mgottschlag/nrf24l01-stick/hardware/nrf24l01-stick.kicad_pcb

## KiCad design hardware/nrf24l01-stick.kicad_pcb (2021-01-23)

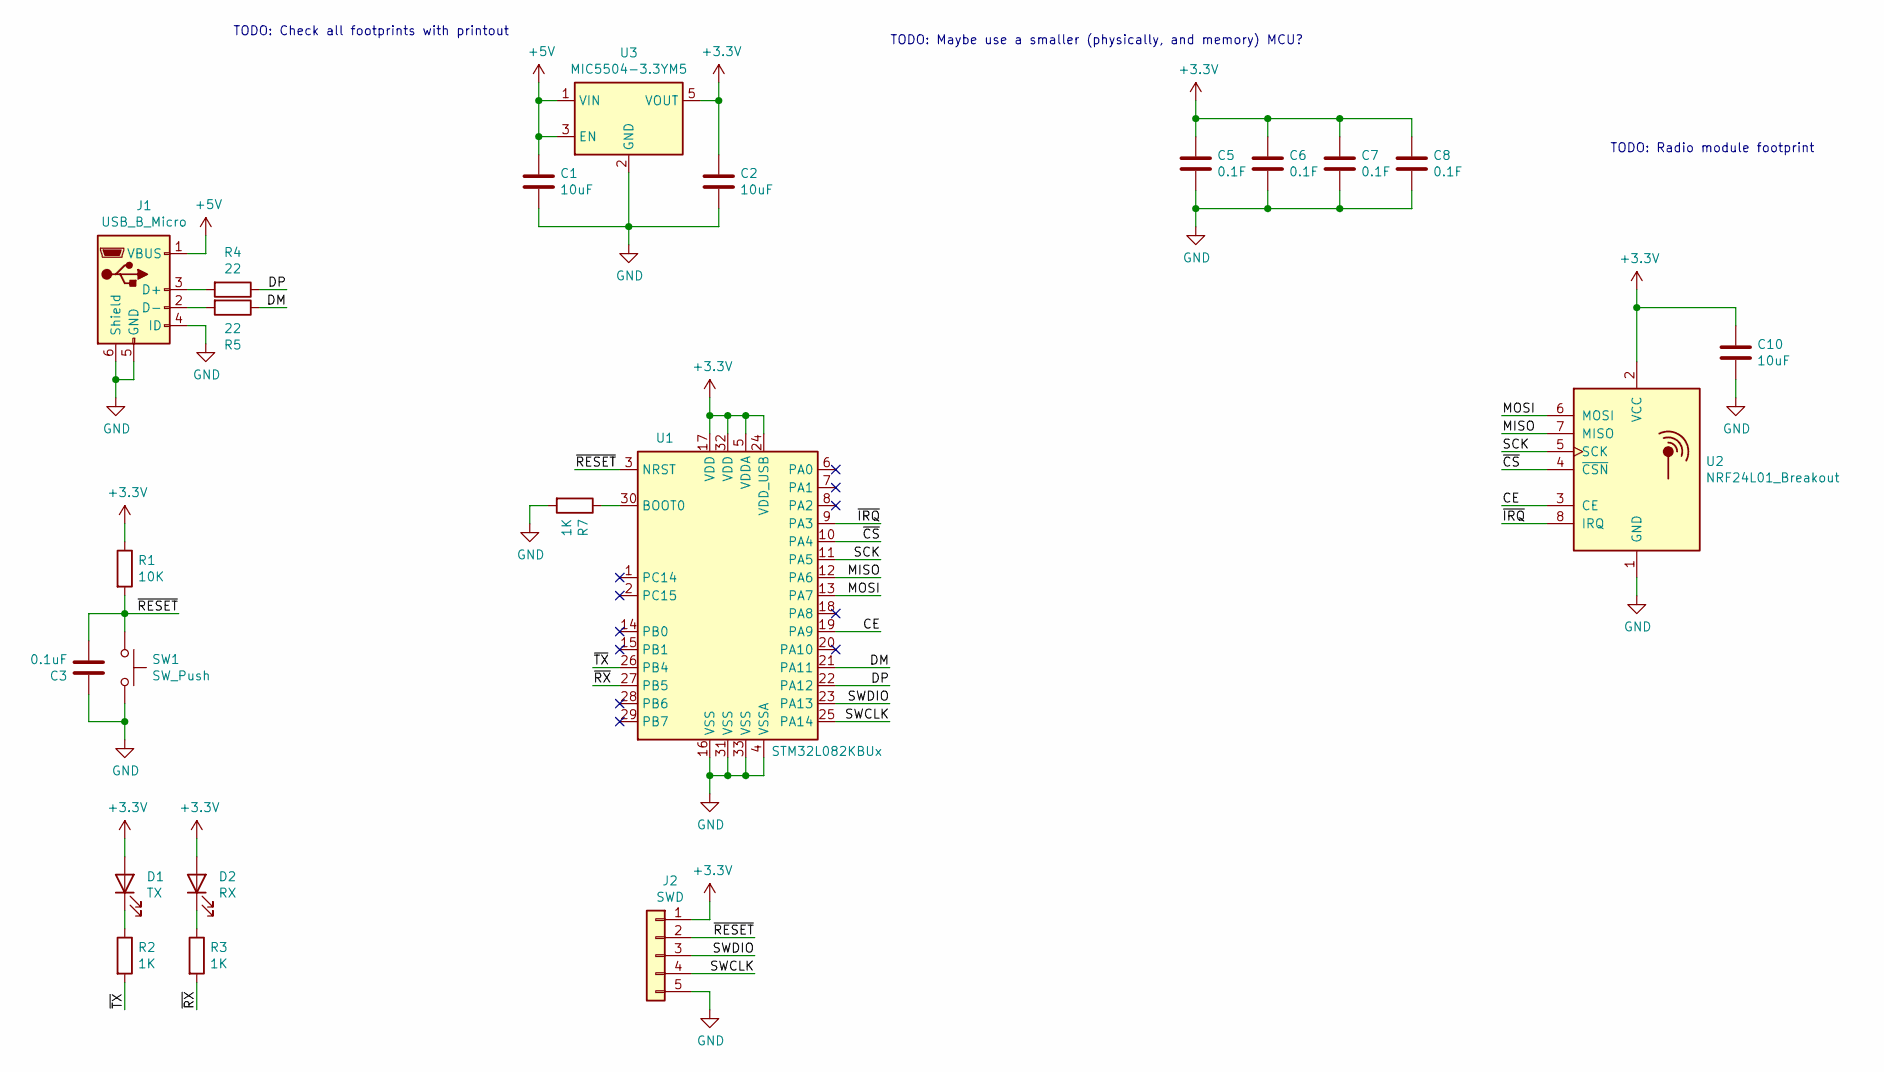
[picture p1: schematic nrf24l01-stick.kicad_sch]

Parts:
C1, C2, C10: 10uF; C_0805_2012Metric
C3: 0.1uF; C_0603_1608Metric
C5, C6, C7, C8: 0.1F; C_0603_1608Metric
D1: TX; LED_0603_1608Metric
D2: RX; LED_0603_1608Metric
J1: USB_B_Micro; USB_Micro-B_Amphenol_10104110_Horizontal
J2: SWD; PinHeader_1x05_P2.54mm_Vertical
R1: 10K; R_0603_1608Metric
R2, R3, R7: 1K; R_0603_1608Metric
R4, R5: 22; R_0603_1608Metric
SW1: SW_Push; SW_Push_1P1T_NO_6x6mm_H9.5mm
U1: STM32L082KBUx; QFN-32-1EP_5x5mm_P0.5mm_EP3.45x3.45mm
U2: NRF24L01_Breakout; NRF24L01_PA_Breakout_SMD
U3: MIC5504-3.3YM5; SOT-23-5

Connections:
+3V3: C2.1, C5.1, C6.1, C7.1, C8.1, C10.1, D1.2 (A), D2.2 (A), J2.1, R1.1, U1.5 (VDDA), U1.17 (VDD), U1.24 (VDD_USB), U1.32 (VDD), U2.2 (VCC), U3.5 (VOUT)
+5V: C1.1, J1.1 (VBUS), U3.1 (VIN), U3.3 (EN)
/CE: U1.19 (PA9), U2.3 (CE)
/DM: R5.1, U1.21 (PA11)
/DP: R4.1, U1.22 (PA12)
/MISO: U1.12 (PA6), U2.7 (MISO)
/MOSI: U1.13 (PA7), U2.6 (MOSI)
/SCK: U1.11 (PA5), U2.5 (SCK)
/SWCLK: J2.4, U1.25 (PA14)
/SWDIO: J2.3, U1.23 (PA13)
/~CS: U1.10 (PA4), U2.4 (~CSN)
/~IRQ: U1.9 (PA3), U2.8 (IRQ)
/~RESET: C3.2, J2.2, R1.2, SW1.1, U1.3 (NRST)
/~RX: R3.2, U1.27 (PB5)
/~TX: R2.2, U1.26 (PB4)
GND: C1.2, C2.2, C3.1, C5.2, C6.2, C7.2, C8.2, C10.2, J1.4 (ID), J1.5 (GND), J1.6 (Shield), J2.5, R7.2, SW1.2, U1.4 (VSSA), U1.16 (VSS), U1.31 (VSS), U1.33 (VSS), U2.1 (GND), U3.2 (GND)
unnamed: D1.1 (K), R2.1
unnamed: D2.1 (K), R3.1
unnamed: J1.2 (D-), R5.2
unnamed: J1.3 (D+), R4.2
unnamed: R7.1, U1.30 (BOOT0)
no_connect_(U1-Pad1): U1.1 (PC14)
no_connect_(U1-Pad2): U1.2 (PC15)
no_connect_(U1-Pad6): U1.6 (PA0)
no_connect_(U1-Pad7): U1.7 (PA1)
no_connect_(U1-Pad8): U1.8 (PA2)
no_connect_(U1-Pad14): U1.14 (PB0)
no_connect_(U1-Pad15): U1.15 (PB1)
no_connect_(U1-Pad18): U1.18 (PA8)
no_connect_(U1-Pad20): U1.20 (PA10)
no_connect_(U1-Pad28): U1.28 (PB6)
no_connect_(U1-Pad29): U1.29 (PB7)
no_connect_(U3-Pad4): U3.4 (NC)

Notes on the sheet:
TODO: Check all footprints with printout
TODO: Maybe use a smaller (physically, and memory) MCU?
TODO: Radio module footprint

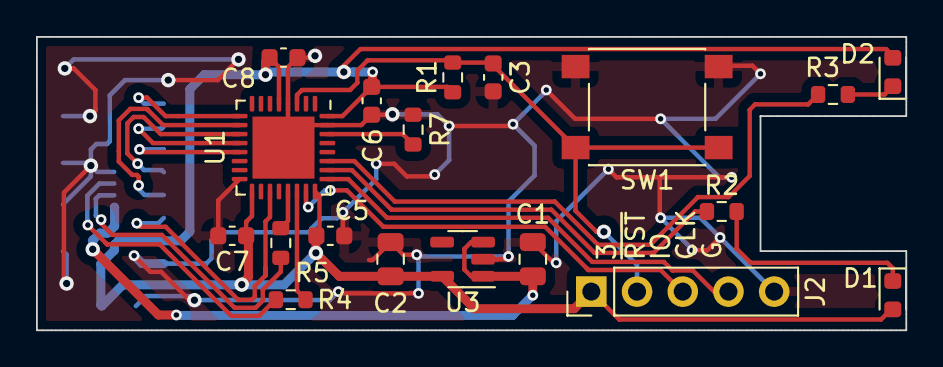
[picture p2: board nrf24l01-stick.kicad_pcb from above]

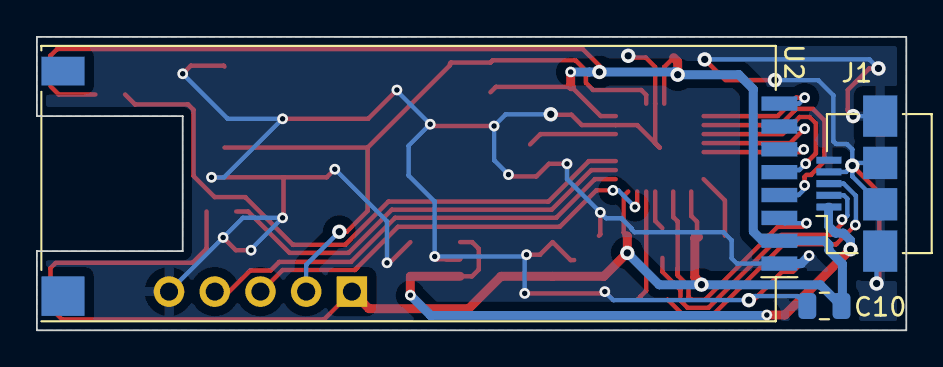
[picture p3: board nrf24l01-stick.kicad_pcb from below]

Board: 2 copper layers, 48.3 x 16.3 mm, 22 parts (3 on the bottom side), 21 nets.
