mgottschlag/nrf24l01-stick/(commit log)

2020-10-14 Initial import (including a dummy USB driver).
2020-10-14 Fix manufacturer/product info and add an udev rule file.
    [main.rs]
2020-10-15 Linux driver API example.
2020-10-16 firmware: Modified to support the bluepill board.
2020-10-16 Some more driver and protocol code.
2020-10-17 More driver implementation and serial device protocol.
2020-10-17 driver: Add tokio codec for packet interface.
2020-10-18 driver: Implemented sending/receiving data via the serial port.
2020-10-18 Improve protocol and driver API to reduce delay between RX/TX.
2020-10-18 driver: Fix out-of-bounds access.
2020-10-18 firmware: Switch to interrupt-based usb.
2020-10-24 firmware: NRF24L01 EXTI interrupt setup.
2020-10-24 driver: Serialize length-1, not length, to eliminate one corner case.
    Packets must never be empty.
2021-01-13 Port firmware to STM32F429 and add more packet processing code.
2021-01-13 firmware: Implement proper responses and reset.
    [adapter.rs]
2021-01-15 driver: Remove debug spam and compiler warnings, fix crash in the example.
2021-01-15 firmware: Use patched NRF24L01 driver.
2021-01-21 Add NRF24L01+PA SMD kicad footprint.
2021-01-21 Add first parts of the PCB.
    [nrf24l01-stick.kicad_pcb, nrf24l01-stick.kicad_sch]
2021-01-22 Designed the rest of the PCB.
    [nrf24l01-stick.kicad_pcb, nrf24l01-stick.kicad_sch]
2021-01-23 Add labels for the SWD pinout.
    [nrf24l01-stick.kicad_pcb]
2021-03-19 Port the firmware to the proper target hardware.
    Interrupt-based USB is still missing.
    [adapter.rs, main.rs]
2021-03-19 firmware: Poll from USB and GPIO interrupts instead of the idle task.
2022-01-27 [driver] Set packet length to size of actual content
2022-01-27 [driver] Do not set tty to exclusive use on macos
2022-01-27 [driver] Allow setting tty as a parameter
